dawidjar97/projekt_smiw_2020/raport/IMG_20200611_144020.jpg

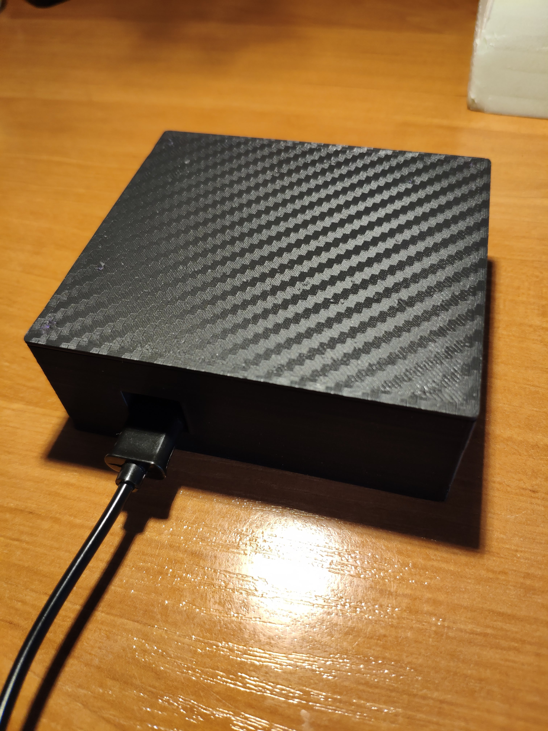
raport/IMG_20200611_144020.jpg
