dawidjar97/projekt_smiw_2020/raport/config1.png

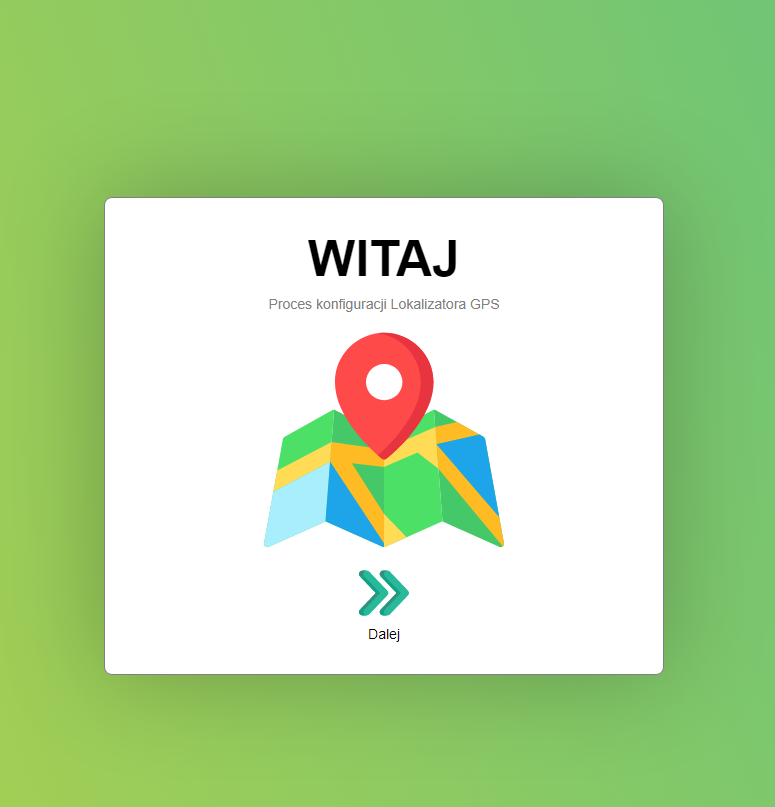
raport/config1.png
