dawidjar97/projekt_smiw_2020/datasheet/graf.png

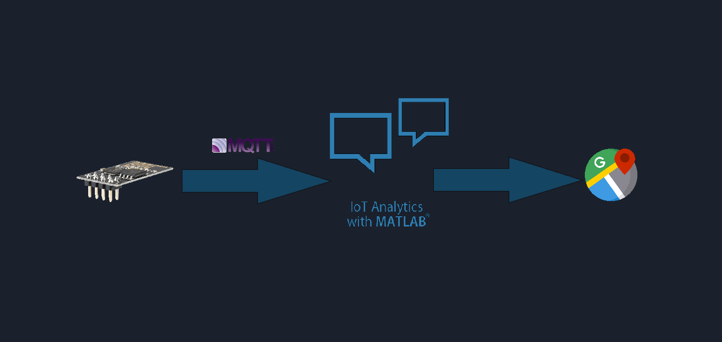
datasheet/graf.png
