dawidjar97/projekt_smiw_2020/datasheet/schemat.png

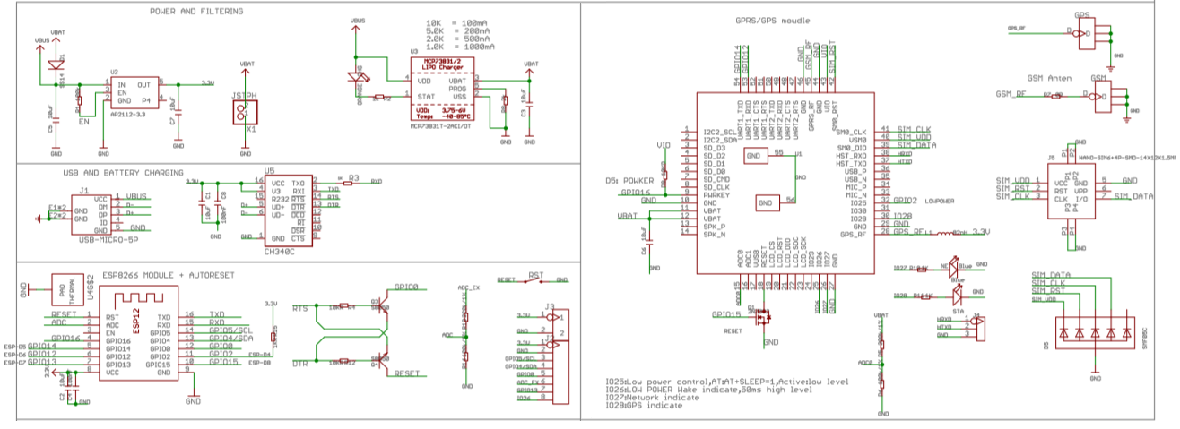
datasheet/schemat.png
