dawidjar97/projekt_smiw_2020/raport/config2.png

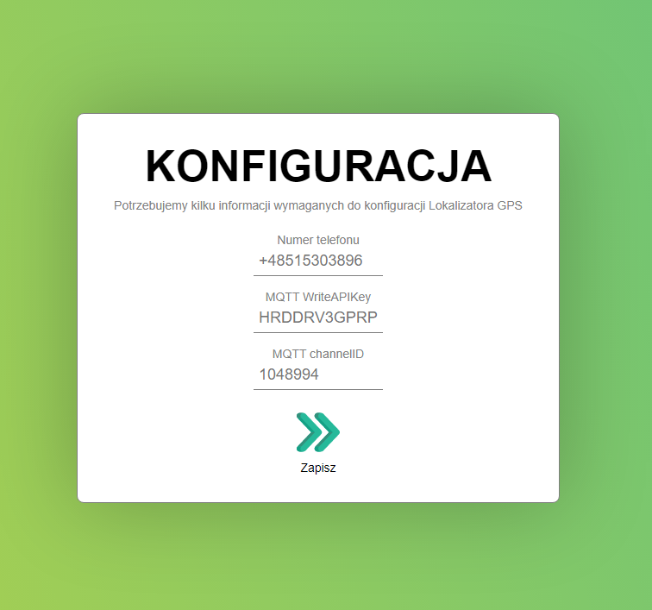
raport/config2.png
