dawidjar97/projekt_smiw_2020/raport/config3.png

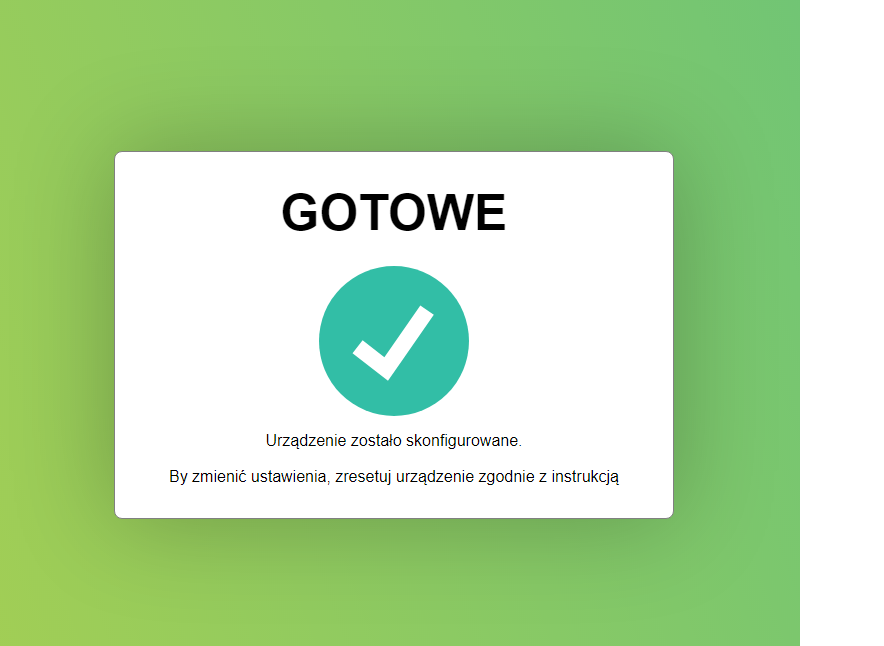
raport/config3.png
