dawidjar97/projekt_smiw_2020/raport/czestotliwosc.png

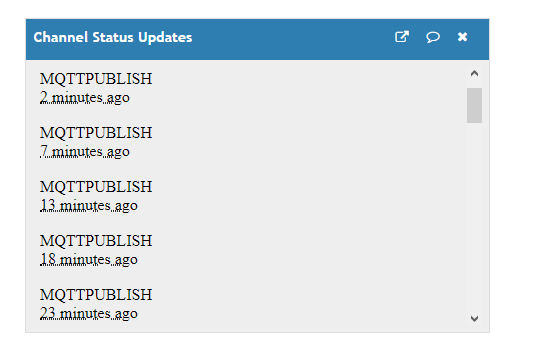
raport/czestotliwosc.png
