dawidjar97/projekt_smiw_2020/raport/IMG_20200611_143727.jpg

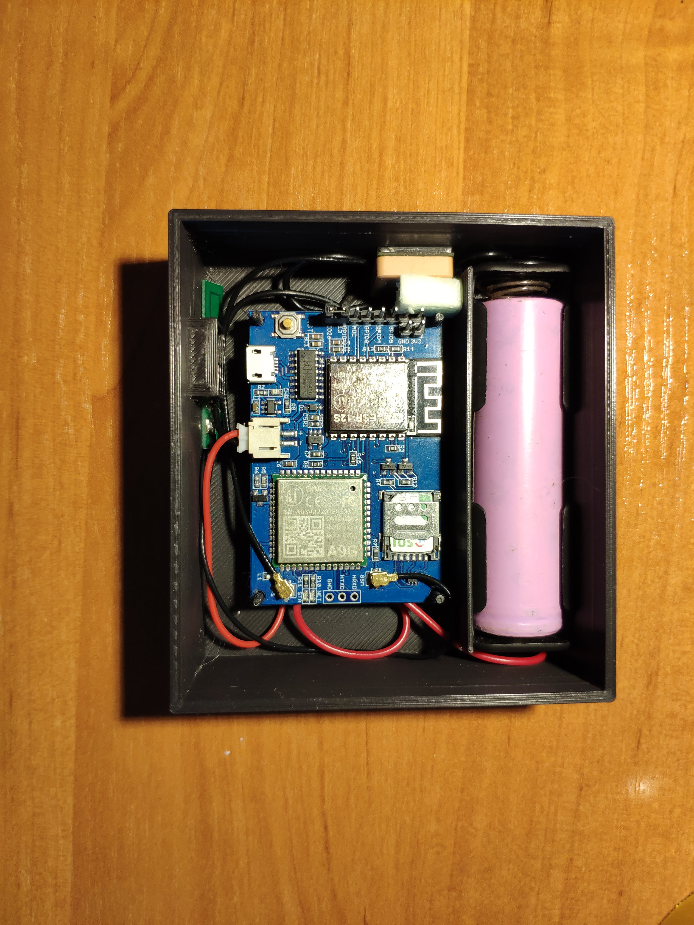
raport/IMG_20200611_143727.jpg
