dawidjar97/projekt_smiw_2020/raport/lokalizacja.jpg

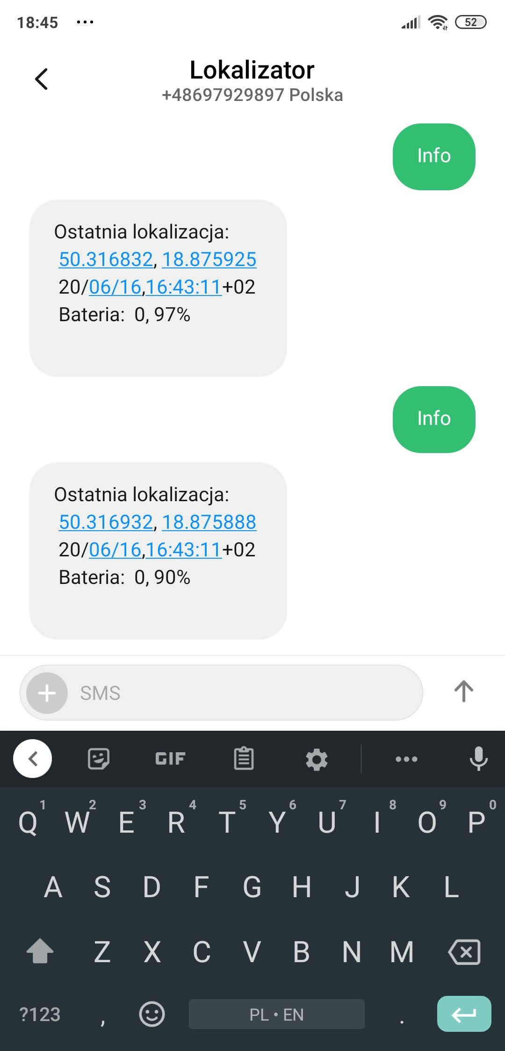
raport/lokalizacja.jpg
