dawidjar97/projekt_smiw_2020/raport/lokalizacja.png

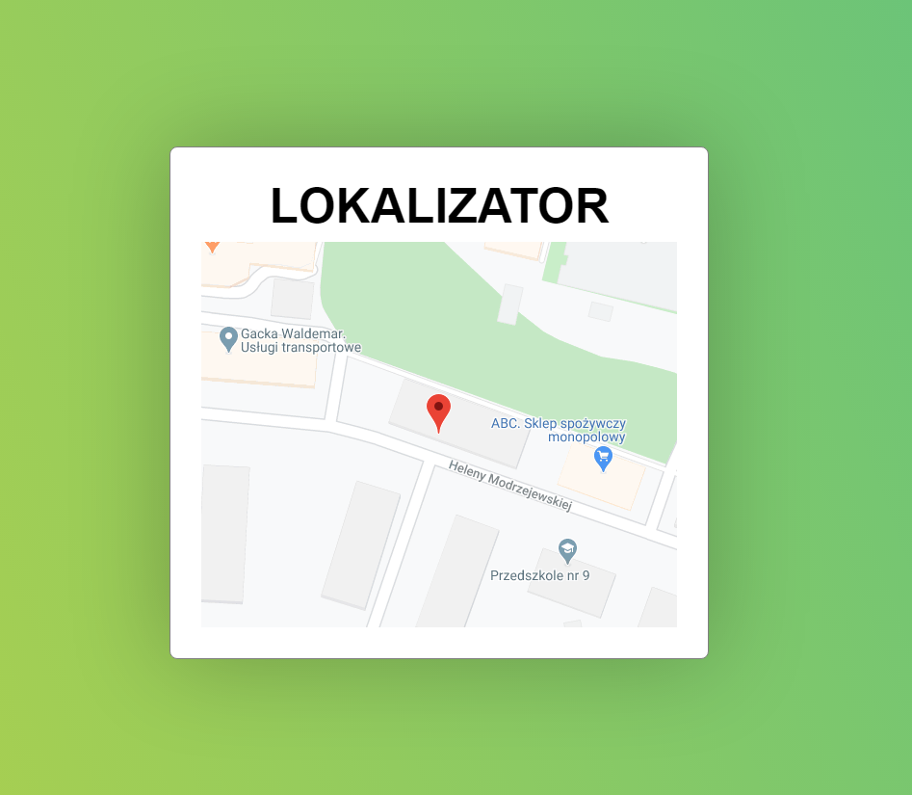
raport/lokalizacja.png
