dawidjar97/projekt_smiw_2020/raport/schemat blokowy.png

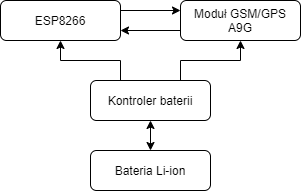
raport/schemat blokowy.png
