dawidjar97/projekt_smiw_2020/raport/software_graf.png

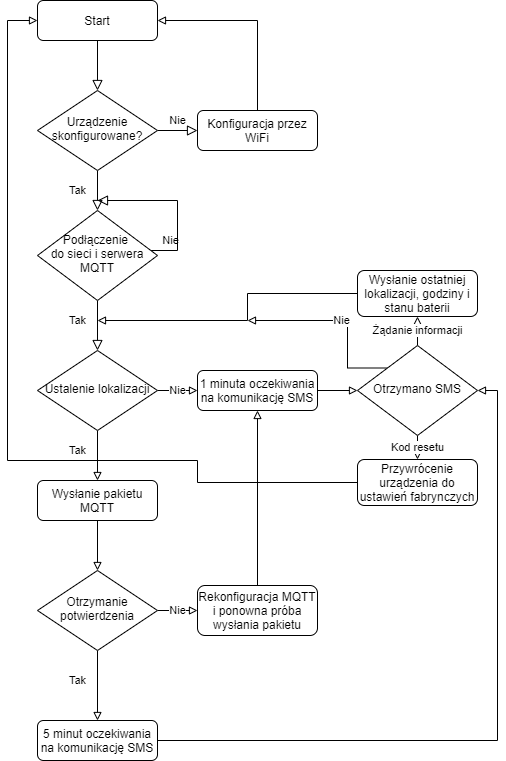
raport/software_graf.png
