dawidjar97/projekt_smiw_2020/raport/wartosci.png

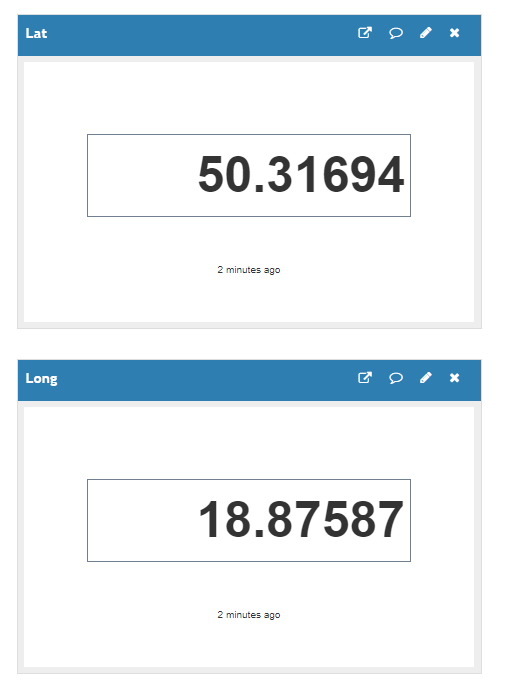
raport/wartosci.png
