dawidjar97/projekt_smiw_2020/raport/wykres.png

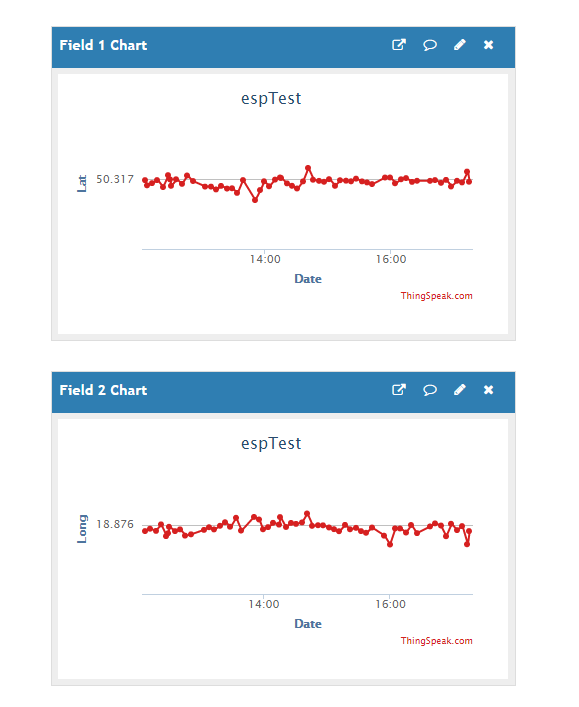
raport/wykres.png
