dawidjar97/projekt_smiw_2020/obudowa/obudowa-a9g.stl

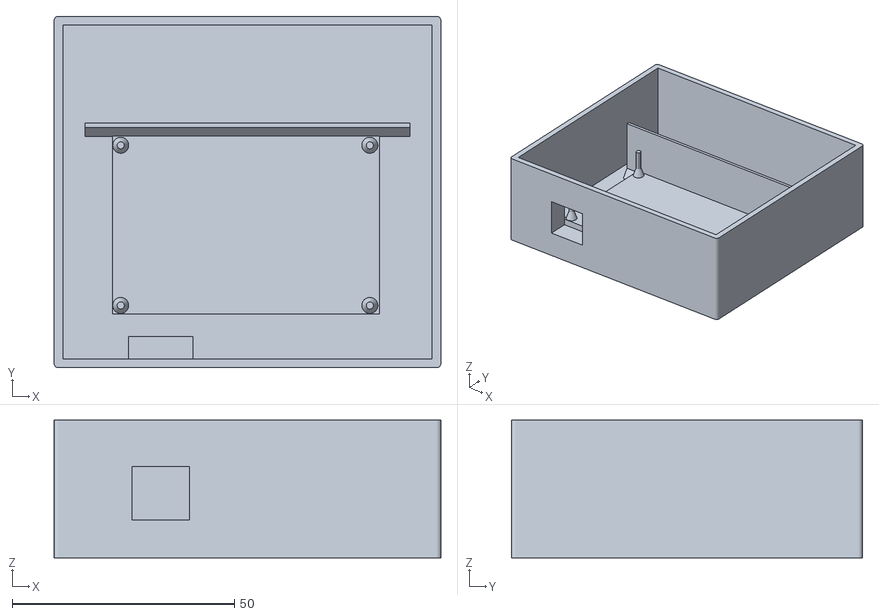
[picture p36: CAD file, 2020-06-09]
obudowa/obudowa-a9g.stl
87.0 x 79.0 x 31.0
