dawidjar97/projekt_smiw_2020/obudowa/klapka-gps.stl

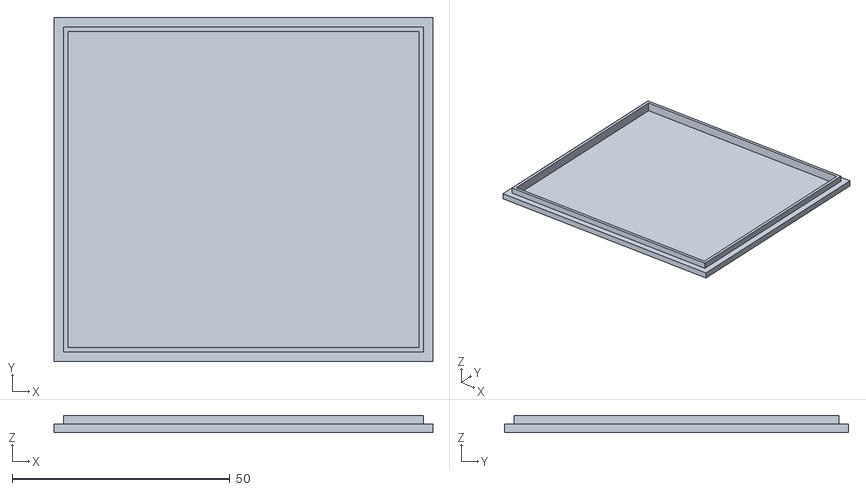
[picture p37: CAD file, 2020-06-09]
obudowa/klapka-gps.stl
87.0 x 79.0 x 4.00
