dawidjar97/projekt_smiw_2020/obudowa/obudowa-gps-v1.stl

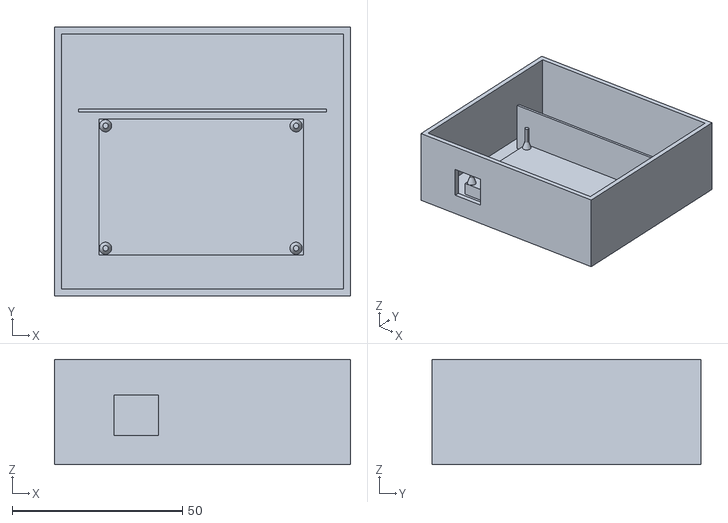
[picture p38: CAD file, 2020-06-09, an earlier design]
obudowa/obudowa-gps-v1.stl
87.0 x 79.0 x 31.0
