dawidjar97/projekt_smiw_2020/(list of files, cad)

Other CAD files:
obudowa/klapka-a9g.stl
obudowa/obudowa-gps-v3.stl
obudowa/obudowa-gps.stl
obudowa/obudowa-gps-v2.stl
