dawidjar97/projekt_smiw_2020/(commit log)

2020-05-27 mqtt reconnect after error
    [main.cpp]
2020-06-09 Work fine
    [klapka-a9g.stl, klapka-gps.stl, obudowa-a9g.stl, obudowa-gps-bieda.stl, obudowa-gps-v2.stl, obudowa-gps-v3.stl, obudowa-gps.stl]
2020-11-03 Leaflet
    batteryLevel fix and Leaflet update
    [A9Gmodule.cpp, main.cpp]
2020-11-22 Added Reset and Restart feature, configuratorServer Lib and Tests
    [configurationServer.h]
2020-12-12 Some descriptions update
    [configurationServer.h]
2020-12-30 Praca inż
    [obudowa-gps-v1.stl]
